PeijieLiuGT/XYZDrumPad/util/vip_drumpad_base.stl

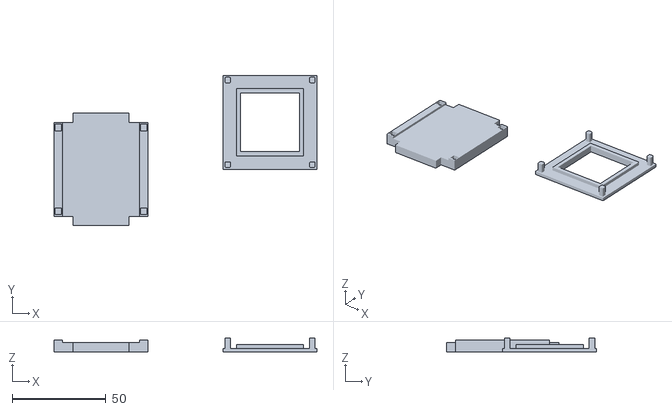
[picture p8: CAD file, 2026-04-27]
util/vip_drumpad_base.stl
140.0 x 80.0 x 7.50
