PeijieLiuGT/XYZDrumPad/util/vip_drumpad_soft_top.stl

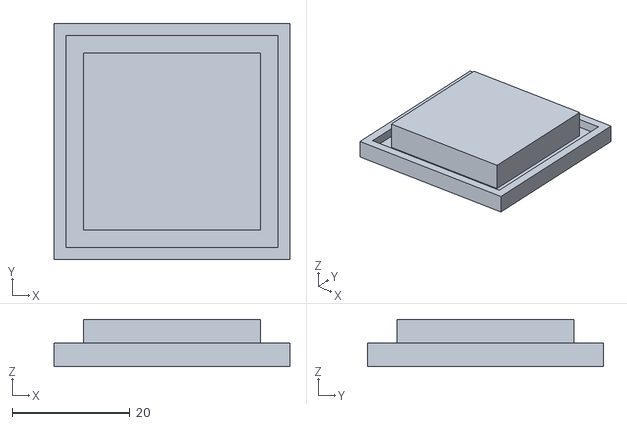
[picture p9: CAD file, 2026-04-27]
util/vip_drumpad_soft_top.stl
40.0 x 40.0 x 8.00
